StachRedeker/LightsGame/Pictures/messyBreadboard.jpeg

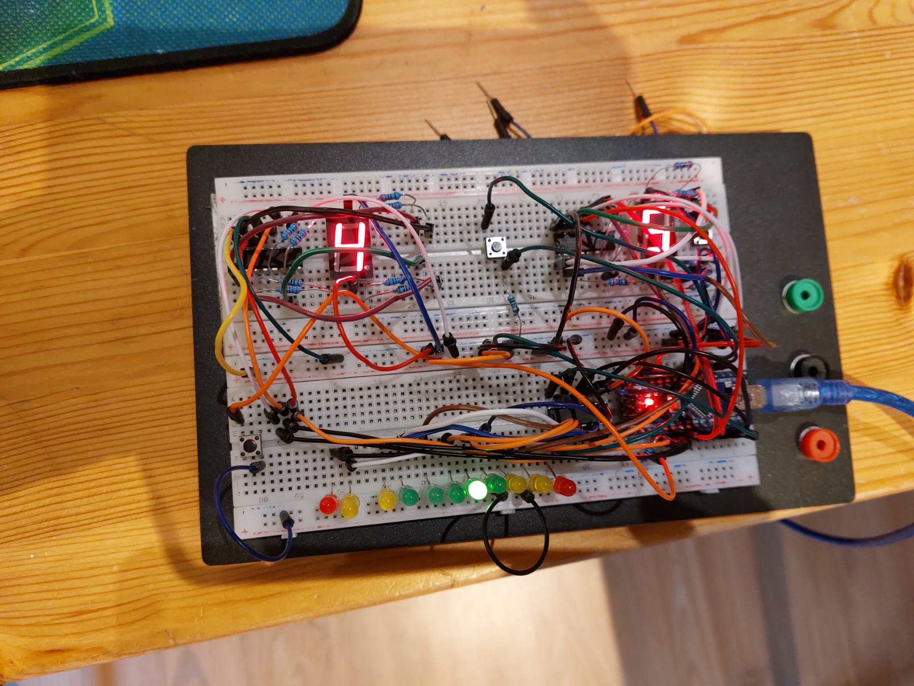
Pictures/messyBreadboard.jpeg
