StachRedeker/LightsGame/PCB/BOM_PCB_LightsGames.csv

ID | Name | Designator | Footprint | Quantity | Manufacturer Part | Manufacturer | Supplier | Supplier Part | Price
1 | K4-12×12_TH | BUTTON1,BUTTON2 | KEY-TH_4P-L12.0-W12.0-P5.00-LS12.5 | 2 | K2-1103DP-M4SW-04 | 韩国韩荣 | LCSC | C128053 | 0.112
2 | LED-TH-5mm_R | LED0,LED1,LED2,LED8,LED9,LED10 | LED-TH_BD5.0_RED | 6 | 333-2SURD/S530-A3 | EVERLIGHT(台湾亿光) | LCSC | C87271 | 0.035
3 | LED-TH-5mm_G | LED3,LED4,LED5,LED6,LED7 | LED-TH_BD5.0_GREEN | 5 | 333-2SYGD/S530-E2 | EVERLIGHT(台湾亿光) | LCSC | C88163 | 0.046
4 | 74HC595D. | R0,R1,R19 | SOP-16_L9.9-W3.9-P1.27-LS6.0-BL | 3 | 74HC595D. | FM富满 | LCSC | C2929943 | 0.047
5 | 220 | R2,R3,R4,R5,R6,R7,R8,R9,R10,R11,R12,R13,R14,R15,R16,R17,R18 | R0603 | 17
6 | 10k | R20,R21 | R0603 | 2
7 | SEG-TH_0.56×1_Cathode | SEG1,SEG2 | LED-SEG-TH_10P-L12.6-W19.0-P2.54-S15.24-BL | 2 |  | 志浩 |  | C8093 | 0.197
8 | ARDUINO_NANO | U1 | COMM-TH_ARDUINO_NANO | 1 | ARDUINO_NANO | null | LCSC | C9900017879
9 | K4-6×6_TH | RESET | KEY-TH_4P-L6.0-W6.0-P4.50-LS6.5 | 1 | K2-1102DP-E4SW-04 | 韩国韩荣 | LCSC | C136684 | 0.04
