StachRedeker/LightsGame/Schematic_LightsGames.pdf

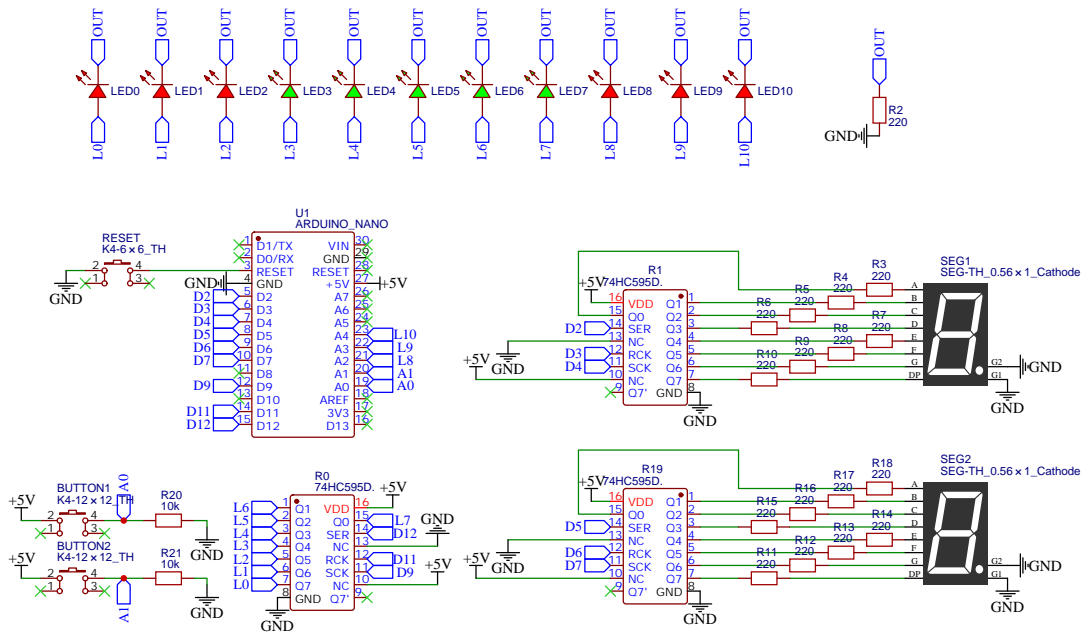
[picture p7: page 1]

NC 10 SCK 11 RCK 12 NC 13 SER 14 Q0 15 VDD 16

GND
