StachRedeker/LightsGame/(list of files, drawings)

Other design files:
PCB/SCH_LightsGames_2023-01-02.json
